camhan22/Go-Kart/Pictures/Day I got it/20170626_204428(0).jpg

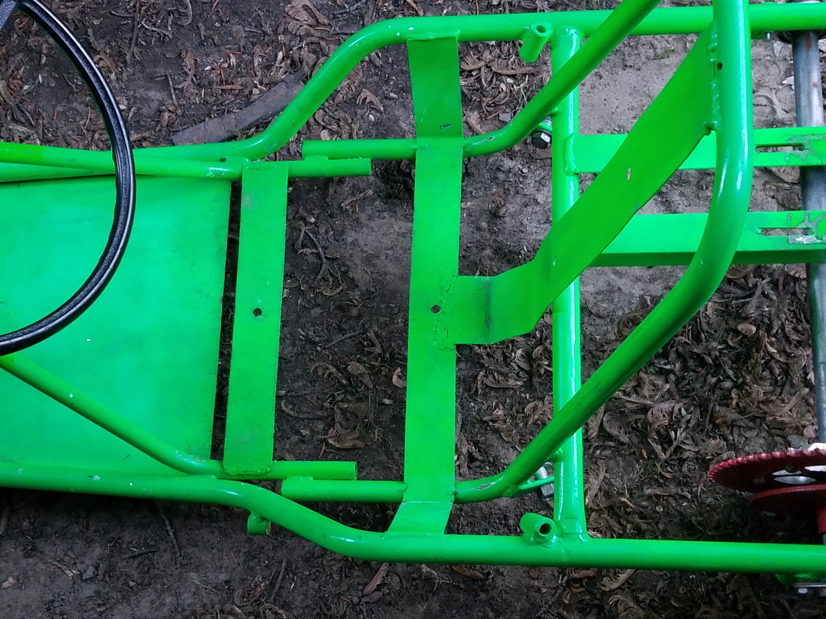
Pictures/Day I got it/20170626_204428(0).jpg
