camhan22/Go-Kart/README.md

# Go-Kart
Electric Go-Kart using 12V FIRST robotics CIM Motors
