camhan22/Go-Kart/Modeling/Notes.txt

Average full throttle acceleration is 6.1535g. (May need to limit the acceleration rate for this system)
