camhan22/Go-Kart/Modeling/Motors/Motor Specifications.xlsx

Sheet: Calculations
Input Voltage | Motor Parameters
12 | Kt | R | B | L | Kv | J
 | 0.01841 | 0.09156461028 | 8.905383993e-05 | 5.9e-05 | 0.0210564841 | 7.75e-05

Sheet: Motor Curve Data
Speed (RPM) | Speed (rad/s) | Torque (N·m) | Friction Torque (N*m) | Eb (V) | Current (A) | Supplied Power (W) | Output Power (W) | Efficiency (%) | Power Dissipation (W)
0 | 0 | 2.413 | 0 | 0 | 131.055 | 1572.66 | 0 | 0 | 1572.66
53.3 | 5.581562948 | 2.38887 | 0.0004888417077 | 0.1175689596 | 129.771 | 1557.252 | 13.334 | 0.856 | 1543.918
106.6 | 11.1631259 | 2.36474 | 0.0009960955324 | 0.2350463546 | 128.488 | 1541.856 | 26.398 | 1.712 | 1515.458
159.9 | 16.74468884 | 2.34061 | 0.00148493724 | 0.3526153142 | 127.204 | 1526.448 | 39.193 | 2.568 | 1487.255
213.2 | 22.32625179 | 2.31648 | 0.001992191065 | 0.4700927092 | 125.921 | 1511.052 | 51.718 | 3.423 | 1459.334
266.5 | 27.90781474 | 2.29235 | 0.002481032772 | 0.5876616688 | 124.637 | 1495.644 | 63.974 | 4.277 | 1431.67
319.8 | 33.48937769 | 2.26822 | 0.002988286597 | 0.7051390638 | 123.354 | 1480.248 | 75.961 | 5.132 | 1404.287
373.1 | 39.07094064 | 2.24409 | 0.003477128305 | 0.8227080233 | 122.07 | 1464.84 | 87.679 | 5.986 | 1377.161
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
