camhan22/Go-Kart/Datasheets/1 IN SHAFT COLLARS.jpg

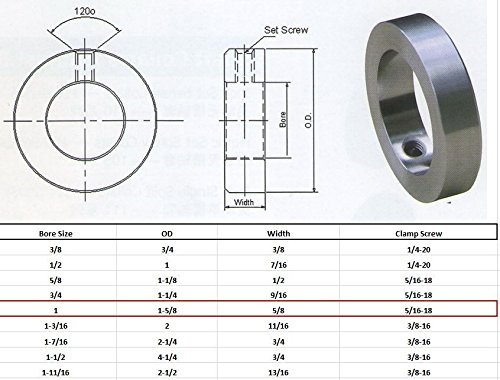
Datasheets/1 IN SHAFT COLLARS.jpg
