camhan22/Go-Kart/Datasheets/51IsZ3rEdWL.jpg

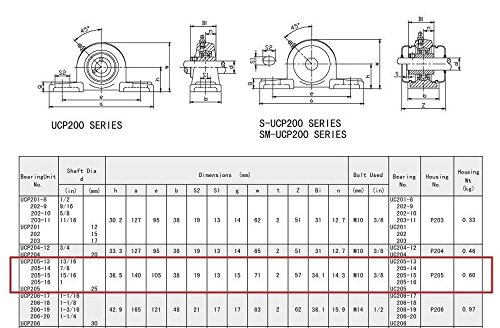
Datasheets/51IsZ3rEdWL.jpg
