camhan22/Go-Kart/Pictures/Foot Pegs - July 17th/20170717_174123.jpg

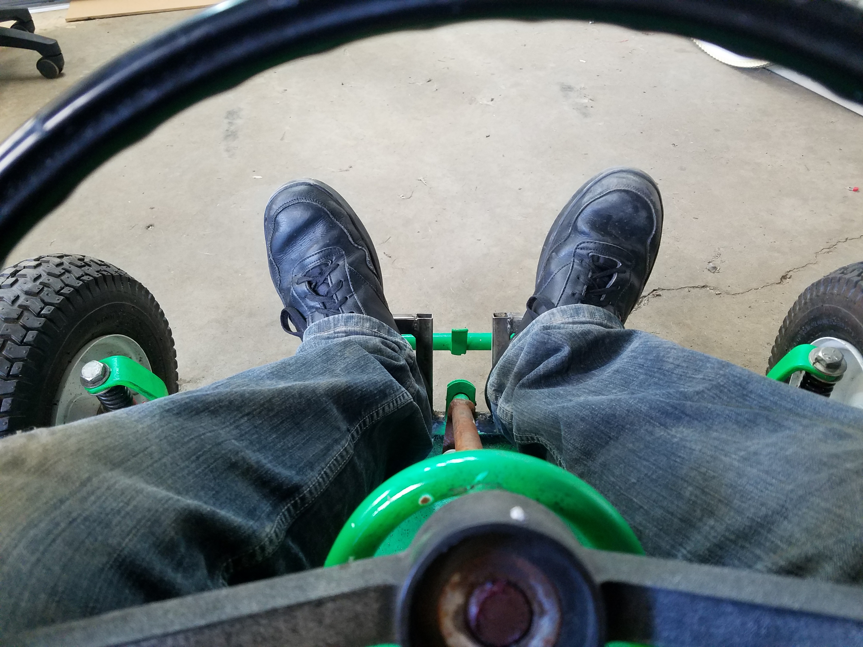
Pictures/Foot Pegs - July 17th/20170717_174123.jpg
