camhan22/Go-Kart/Go-Kart BOM.xlsx

Sheet: BOM
Description | Vendor | Item # | Cost | Quantity Needed | WEIGHT | Notes
SPROCKETS AND CHAIN
1" AXLE 42 TOOTH HUB AND SPROCKET | GOKARTSUSA | 2562 | $47.85 | 2 |  | MAYBE REPLACE WITH 35B42F-1 FROM AMAZON TO REDUCE SHIPPING COST
500EX HEX HUB | ANDYMARK | AM-2568 | $9.50 | 4 | 0.088
#35 CHAIN(10FT) | VEXPRO | 217-2776 | $9.99 | 1 | 1.014
MASTER LINK | ANDYMARK | AM-0368 | $0.75 | 2 | 0.01
42 TOOTH #35 SPROCKET | VEXPRO | 217-2648 | $12.99 | 2 | 0.28
 |  |  | Total: | $171.17
DRIVETRAIN COMPONENTS
2.5" CIM MOTOR | VEXPRO | 217-2000 | $27.99 | 6 | 2.82
3 CIM BALL SHIFTER | VEXPRO | 217-3268 | $241.94 | 2 | 3.903 | 3.68 Spread with 3rd stage at 50:34
12V 30 AMP BATTERY CHARGER | BATTERYSTUFF | SEC-1230UL | $218.00 | 1 | 0
120 AMP MAIN BREAKER | AMAZON.COM | CB185-120 | $29.98 | 1 | 0.2
12V DURACELL ULTRA BATTERY | BATTERIES PLUS | SLI12V215S | $332.99 | 1 | 127
6 WAY FUSE HOLDER | AMAZON.COM | NC-A001-20 | 12.99 | 1 | 0.2625
4 AWG BLACK WIRE(BY THE FOOT) | HOME DEPOT | 20502199 | 0.86 | 3
4 AWG RED WIRE(BY THE FOOT) | HOME DEPOT | 20498299 | 1.19 | 3
COMPLETE SPINDLE SET (4-1/2" X 5/8") | BMI KARTS | 421400 | $31.50 | 2 |  | FOR THE FRONT END
3/4 x 16 NYLOCK HEX NUTS | EBAY.COM | 3/4 x 16 NYLOCK HEX NUTS | $13.10 | 1 |  | 25 per bag
7" X 5-3/4" FRONT RIMS | BMI KARTS | K260037 | $18.95 | 2
PAIR REAR AXLE PILLOW BLOCK | AMAZON.COM | UCP205-16 | $16.68 | 2 | 6
7" X 5-3/4" RIM (1" BORE) | BMI KARTS | 260038 | $18.95 | 2 |  | FOR THE REAR TIRES
KENDA K530 PATHFINDER TIRES | EBAY.COM | 1877KPF-2 | $70.80 | 1 |  | COMES AS A PAIR WITH FREE SHIPPING
1" DIA. 48" LONG KEYED SHAFT | AMAZON.COM | 1 GKS-1045-48 | $60.99 | 1
1" BORE ZINC PLATED SHAFT COLLARS | AMAZON.COM | 762931496962 | $15.50 | 2 |  | FREE SHIPPING
18-8 1/4" KEYWAY(12" LONG) | AMAZON.COM | SPKS279 | $8.71 | 2 | 0.2175
 |  |  | Total: | $1507.99
DISPLAY COMPONENTS
PANEL MOUNT VOLTMETER WITH CURRENT SHUNT | AMAZON.COM | 711463670166 | $18.75 | 1
I2C 2004 LCD SCREEN | AMAZON.COM | B01GPUMP9C | $11.99 | 1
4 PIN LATCHING ROCKER SWITCH | AMAZON.COM | USS-WBS00009 | $6.95 | 1
 |  |  | Total: | $37.69
Frame
KART FRAME
 |  |  |  | 1 | 81.83
 |  |  | Total: | $0.00
Controls
SLIDE POTENTIOMETER(10k)(100mm) | MOUSER | 652-PTB01532010BPB10 | $4.93 | 1
ARDUINO MEGA2560 | AMAZON.COM | B01H4ZLZLQ | $12.86 | 1
ADAFRUIT ULTIMATE GPS | AMAZON.COM | OMEL-MR-PN-6693723 | $39.93 | 1
10" STEERING WHEEL | AMAZON.COM | B005FMT2RA | $23.88 | 1
JEGS PERFORMANCE SEAT | AMAZON.COM | 555-70200 | $34.99 | 1
4 POINT RACE HARNESS | AMAZON.COM | 2V-8TCC-ASKP | $29.99 | 1
12V 2 POSITION SOLENOID | EBAY.COM | 4V210-08 DC12V | $9.69 | 1
300 PSI MINI AIR COMPRESSOR | EBAY.COM | 672588 | $10.26 | 1
BALL SHIFTER PNUEMATIC FITTING KIT | VEXPRO | 217-2907 | $9.99 | 1
1/4" O.D. 25FT ROLL TUBING | HOME DEPOT | 701873 | $3.98 | 1
PNUEMATIC PRESSURE REGULATOR | AMAZON.COM | BTFP72326 | $10.44 | 1
1/4" MALE THREAD TO PUSH CONNECT FITTINGS | AMAZON.COM | J06 | $7.99 | 1
 |  |  | Total: | $198.93
TOTAL COST: | $1915.78 |  |  | WEIGHT: | 248.3995

Sheet: ORDERING
VEXPRO | QTY | ANDYMARK | QTY | GOKARTSUSA | QTY | EBAY.COM | QTY | AMAZON.COM | QTY | METALSDEPOT | QTY | MOUSER | QTY | BMI KARTS | QTY | HOME DEPOT | QTY | BATTERYSTUFF | QTY
217-2776 | 1 | AM-2568 | 4 | 2562 | 2 | 3/4 x 16 NYLOCK HEX NUTS | 1 | CB185-120 | 1 |  |  | 652-PTB01532010BPB10 | 1 | 421400 | 2 | 20502199 | 3 | SEC-1230UL | 1
217-2648 | 2 | AM-0368 | 2 |  |  | 1877KPF-2 | 1 | NC-A001-20 | 1 |  |  |  |  |  |  | 20498299 | 3
217-2000 | 6 |  |  |  |  | 4V210-08 DC12V | 1 | UCP205-16 | 2 |  |  |  |  |  |  | 701873 | 1
217-3268 | 2 |  |  |  |  | 672588 | 1 | 1 GKS-1045-48 | 1
217-2907 | 1 |  |  |  |  |  |  | 762931496962 | 2
 |  |  |  |  |  |  |  | SPKS279 | 2
 |  |  |  |  |  |  |  | 711463670166 | 1
 |  |  |  |  |  |  |  | B01GPUMP9C | 1
 |  |  |  |  |  |  |  | USS-WBS00009 | 1
 |  |  |  |  |  |  |  | B01H4ZLZLQ | 1
 |  |  |  |  |  |  |  | OMEL-MR-PN-6693723 | 1
 |  |  |  |  |  |  |  | B005FMT2RA | 1
 |  |  |  |  |  |  |  | 555-70200 | 1
 |  |  |  |  |  |  |  | 2V-8TCC-ASKP | 1
 |  |  |  |  |  |  |  | BTFP72326 | 1
 |  |  |  |  |  |  |  | J06 | 1

Sheet: PREMADE FRAME
Description | Vendor | Item # | Cost | Quantity Needed | WEIGHT | Notes
SPROCKETS AND CHAIN
1" AXLE 42 TOOTH HUB AND SPROCKET | GOKARTSUSA | 2562 | $21.90 | 2
500EX HEX HUB | ANDYMARK | AM-2568 | $9.50 | 4
#35 CHAIN(10FT) | ANDYMARK | AM-0367 | $12.00 | 1
MASTER LINK | ANDYMARK | AM-0368 | $0.75 | 2
42 TOOTH #35 SPROCKET | VEXPRO | 217-2648 | $12.99 | 2
 |  |  | Total: | $121.28
DRIVETRAIN COMPONENTS
2.5" CIM MOTOR | VEXPRO | 217-2000 | $27.99 | 6
3 CIM BALL SHIFTER | VEXPRO | 217-3268 | $241.94 | 2 |  | 3.68 Spread with 3rd stage at 50:34
12V DURALAST PLATINUM BATTERY | AUTOZONE | H8-AGM | $207.99 | 2
REAR AXLE PILLOW BLOCK | AMAZON.COM | UCP205-16 | $14.98 | 4
 |  |  | Total: | $1127.72
DISPLAY COMPONENTS
PANEL MOUNT VOLT METER | EBAY.COM | PANEL MOUNT VOLT METER | $13.95 | 1
4 PIN LATCHING ROCKER SWITCH | AMAZON.COM | USS-WBS00009 | $6.95 | 1
 |  |  | Total: | $20.90
Frame
 |  |  | Total: | $0.00
Controls
SLIDE POTENTIOMETER(10k)(100mm) | MOUSER | 652-PTB01532010BPB10 | $4.93 | 1
ARDUINO MEGA2560 | AMAZON.COM | B01H4ZLZLQ | $12.86 | 1
12V 2 POSITION SOLENOID | EBAY.COM | 4V210-08 DC12V | $9.69 | 1
300 PSI MINI AIR COMPRESSOR | EBAY.COM | 672588 | $10.26 | 1
BALL SHIFTER PNUEMATIC FITTING KIT | VEXPRO | 217-2907 | $9.99 | 1
1/4" O.D. 25FT ROLL TUBING | HOME DEPOT | 701873 | $3.98 | 1
PNUEMATIC PRESSURE REGULATOR | AMAZON.COM | BTFP72326 | $10.44 | 1
1/4" MALE THREAD TO PUSH CONNECT FITTINGS | AMAZON.COM | J06 | $7.99 | 1
 |  |  | Total: | $70.14
TOTAL COST: | $1340.04

Sheet: PREMADE FRAME ORDERING
VEXPRO | QTY | ANDYMARK | QTY | GOKARTSUSA | QTY | AUTOZONE | QTY | EBAY.COM | QTY | AMAZON.COM | QTY | METALSDEPOT | QTY | MOUSER | QTY | BMI KARTS | QTY | HOME DEPOT | QTY
217-2648 | 2 | AM-2568 | 4 | 2562 | 2 | H8-AGM | 2 | PANEL MOUNT VOLT METER | 1 | UCP205-16 | 4 |  |  | 652-PTB01532010BPB10 | 1 |  |  | 701873 | 1
217-2000 | 6 | AM-0367 | 1 |  |  |  |  | 4V210-08 DC12V | 1 | USS-WBS00009 | 1
217-3268 | 2 | AM-0368 | 2 |  |  |  |  | 672588 | 1 | B01H4ZLZLQ | 1
217-2907 | 1 |  |  |  |  |  |  |  |  | BTFP72326 | 1
 |  |  |  |  |  |  |  |  |  | J06 | 1
