camhan22/Go-Kart/Modeling/Go-Kart BOM.xlsx

Item | Description | Part Number | Cost | Quantity | Actual Qty | Manufacturer | Supplier | Purchased | Webstore Link
Drivetrain
Motor | 2.5" CIM Motor with no output gear |  | $33.00 | 6 | 6 | AndyMark | AndyMark | N | https://www.andymark.com/products/2-5-in-cim-motor?Pinion%20Option=No%20Pinion&quantity=1
Cim Motor Gear | 14 Tooth 20DP 8 mm Round with 2 mm Key Steel CIM Gear |  | $10.00 | 6 | 6 | AndyMark | AndyMark | N | https://www.andymark.com/products/14t-20dp-8mm-round-with-2mm-key-steel-gear
Optical Encoder for Speed | E4T OEM Miniature Optical Encoder Kit |  | $38.00 | 2 | 2 | AndyMark | AndyMark | N | https://www.andymark.com/products/e4t-oem-miniature-optical-encoder-kit
Encoder Mount | Encoder Mount Pad Spacer V2 |  | $3.50 | 2 | 2 | AndyMark | AndyMark | N | https://www.andymark.com/products/encoder-mount-pad-v2
Transmission | Toughbox Gearbox 3 Motor with 12.75:1 Ratio |  | $79.00 | 2 | 2 | AndyMark | AndyMark | N | https://www.andymark.com/products/toughbox-3-motor-with-12-75-1-ratio
Chain | #35 Single Strand-Riveted Roller Chain 10' |  | $12.00 | 1 | 1 | AndyMark | AndyMark | N | https://www.andymark.com/products/35-single-strand-riveted-roller-chain-10
Chain Master Links | #35 Roller Chain Connecting Link |  | $1.00 | 0 | 5 | AndyMark | AndyMark | N | https://www.andymark.com/products/35-connecting-link-for-roller-chain
Chain Half Links | #35 Roller Chain Half Link |  | $2.00 | 0 | 5 | AndyMark | AndyMark | N | https://www.andymark.com/products/35-half-link-for-roller-chain
Tranmission Output Gear |  |  |  | 1 | 1 | AndyMark | AndyMark
Drive Shaft Gear |  |  |  | 1 | 1 | AndyMark | AndyMark
Throttle
Potentiometer to Digital Converter | Dual channel 256 step digital potentiometer IC | ‎DS18030-010+-ND | $4.83 | 1 | 2 | Maxim Integrated | Digi-Key | Y | https://www.digikey.com/en/products/detail/maxim-integrated/DS18030-010/951284
Throttle Potentiometers | 10k 250 degree pots | 284TBCF103A26A1 | $12.38 | 2 | 2 | CTS Electrocomponents | Digi-Key | Y | https://www.digikey.com/en/products/detail/cts-electrocomponents/284TBCF103A26A1/3045559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
