camhan22/Go-Kart/E2M Converter/BOM.xlsx

Schematic Annotation | Part Number | Description | Qty | Price | Supplier | Total Cost | Link
U2 | ATTINY85-20PU-ND | AVR series Microcontroller IC 8-Bit 20MHz 8KB (4K x 16) FLASH 8-PDIP | 1 | $1.45 | Digikey | $1.45 | https://www.digikey.com/en/products/detail/microchip-technology/ATTINY85-20PU/735469
U1 | 497-2947-5-ND | Linear Voltage Regulator IC Positive Fixed 1 Output 1.5A TO-220AB | 1 | $0.54 | Digikey | $0.54 | https://www.digikey.com/en/products/detail/stmicroelectronics/L7805ABV/634711
J1 | 277-6156-ND | 2 Position Wire to Board Terminal Block 45° (135°) Angle with Board 0.098" (2.50mm) Through Hole | 1 | $0.31 | Digikey | $0.31 | https://www.digikey.com/en/products/detail/phoenix-contact/1989748/2513965
J2 | 23-0022292051-ND | Connector Header Through Hole 5 position 0.100" (2.54mm) | 1 | $1.43 | Digikey | $1.43 | https://www.digikey.com/en/products/detail/molex/0022292051/1130591
J2 Mate | 23-0010112053-ND | 5 Rectangular Connectors - Housings Receptacle White 0.100" (2.54mm) | 1 | $0.29 | Digikey | $0.29 | https://www.digikey.com/en/products/detail/molex/0010112053/171981
J2 Crimps | WM3724CT-ND | Socket Contact Tin 22-28 AWG Crimp - | 5 | $0.12 | Digikey | $0.60 | https://www.digikey.com/en/products/detail/molex/0008700056/2421861
C1,C2 | 732-8851-1-ND | 1 µF 50 V Aluminum Electrolytic Capacitors Radial, Can - 2000 Hrs @ 105°C | 2 | $0.10 | Digikey | $0.20 | https://www.digikey.com/en/products/detail/w%C3%BCrth-elektronik/860020672005/5728796
M2 | 102-5593-ND | Fan Tubeaxial 12VDC Square - 40mm L x 40mm H omniCOOL™ Magnetic Sleeve 5.5 CFM (0.154m³/min) 2 Wire Leads | 1 | $5.57 | Digikey | $5.57 | https://www.digikey.com/en/products/detail/cui-devices/CFM-4020V-145-123/7605411
Heatsink | HS106-ND | Heat Sink TO-220 Aluminum 3.0W @ 80°C Board Level | 1 | $0.33 | Digikey | $0.33 | https://www.digikey.com/en/products/detail/aavid-thermal-division-of-boyd-corporation/577102B00000G/108319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
Heatsink Bolt | 91274A102 | Zinc-Aluminum-Coated Alloy Steel Socket Head Screw | 1 | $5.38 | Mcmaster Carr | $5.38 | https://www.mcmaster.com/91274A102/
Heatsink Nut | 90592A085 | Steel Hex Nut | 1 | $1.17 | Mcmaster Carr | $1.17 | https://www.mcmaster.com/90592A085/
Servo Motor | 1528-1083-ND | Positional Rotation DC Motor Servomotor, RC (Hobby) - - - 5VDC | 1 | $19.95 | Digikey | $19.95 | https://www.digikey.com/en/products/detail/adafruit-industries-llc/1142/5154658
Throttle Cable | B071VPYPD7 | 82 Inch Go Kart Throttle Cable Line Wire For 150CC 250CC Carter Throttle Cable Accessories | 1 | $9.50 | Amazon.com | $9.50 | Amazon.com: 82 Inch Go Kart Throttle Cable Line Wire For 150CC 250CC Carter Throttle Cable Accessories: Automotive (https://www.amazon.com/Throttle-Cable-150CC-Carter-Accessories/dp/B071VPYPD7)
 |  |  |  |  | Total Cost | $46.72
