camhan22/Go-Kart/Throttle/BOM.xlsx

Schematic Annotation | Part Number | Description | Qty | Price | Supplier | Total Cost | Link
 | 1772-1230-ND | Hex Standoff Threaded #4-40 Aluminum 0.250" (6.35mm) 1/4" - | 4 | $0.46 | Digikey | $1.84 | https://www.digikey.com/en/products/detail/raf-electronic-hardware/4501-440-AL/7680641
 | H216-ND | #4-40 Hex Nut 0.250" (6.35mm) 1/4" - | 4 | $0.02 | Digikey | $0.08 | https://www.digikey.com/en/products/detail/b-f-fastener-supply/HNZ-440/5738
 | 1528-1195-ND | Breadboard, General Purpose Plated Through Hole (PTH) 5 Hole Pad (Both Sides) - | 1 | $4.50 | Digikey | $4.50 | https://www.digikey.com/en/products/detail/adafruit-industries-llc/1609/5353655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
 | 2139580 | M6-1.0 x 100mm DIN 912 Hex Drive Class 12.9 Black Oxide Finish Alloy Steel Socket Cap Screw | 2 | $1.75 | Fastenal | $3.50 | https://www.fastenal.com/products/details/2139580
 | 210129065 | M6-1.0 DIN 934 Yellow Zinc Finish Steel Class 10 Hex Nut | 2 | $0.35 | Fastenal | $0.70 | https://www.fastenal.com/products/details/210129065
 | 11545703 | M6 x 12mm OD DIN 125 Grade HV200 Yellow Zinc Finish Steel Type A General Purpose Flat Washer | 2 | $0.17 | Fastenal | $0.35 | https://www.fastenal.com/products/details/11545703
U1 | ATTINY85-20PU-ND | AVR series Microcontroller IC 8-Bit 20MHz 8KB (4K x 16) FLASH 8-PDIP | 1 | $1.45 | Digikey | $1.45 | https://www.digikey.com/en/products/detail/microchip-technology/ATTINY85-20PU/735469
J1 | 23-0022292051-ND | Connector Header Through Hole 5 position 0.100" (2.54mm) | 1 | $1.43 | Digikey | $1.43 | https://www.digikey.com/en/products/detail/molex/0022292051/1130591
J1 Mate | 23-0010112053-ND | 5 Rectangular Connectors - Housings Receptacle White 0.100" (2.54mm) | 1 | $0.29 | Digikey | $0.29 | https://www.digikey.com/en/products/detail/molex/0010112053/171981
J1 Crimps | WM3724CT-ND | Socket Contact Tin 22-28 AWG Crimp - | 4 | $0.12 | Digikey | $0.48 | https://www.digikey.com/en/products/detail/molex/0008700056/2421861
J2 | 277-6156-ND | 2 Position Wire to Board Terminal Block 45° (135°) Angle with Board 0.098" (2.50mm) Through Hole | 1 | $0.31 | Digikey | $0.31 | https://www.digikey.com/en/products/detail/phoenix-contact/1989748/2513965
RV1, RV2 | CT3033-ND | 10k Ohm 1 Gang Linear Panel Mount Potentiometer None 1.0 Kierros Conductive Plastic 0.25W, 1/4W Solder Lug | 2 | $11.90 | Digikey | $23.80 | https://www.digikey.com/en/products/detail/cts-electrocomponents/284TBCF103A26A1/3045559
 |  |  |  |  | Total Cost | $38.73
