camhan22/Go-Kart/Throttle/Throttle Body.stl

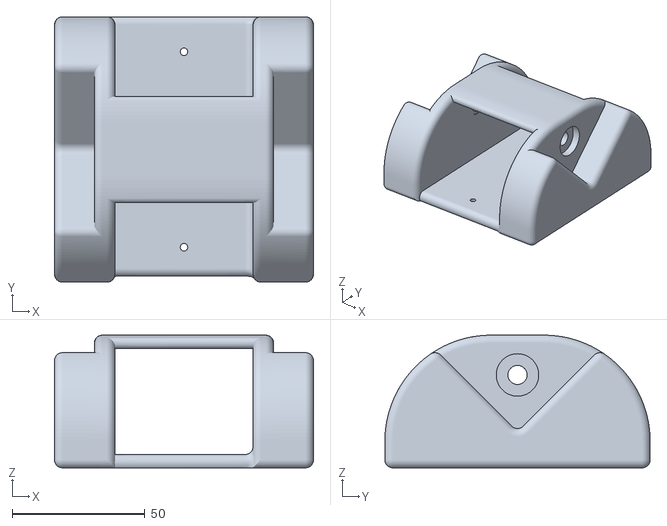
[picture p13: CAD file, 2021-06-26]
Throttle/Throttle Body.stl
97.6 x 100.0 x 50.0
