camhan22/Go-Kart/Throttle/Throttle Handle.stl

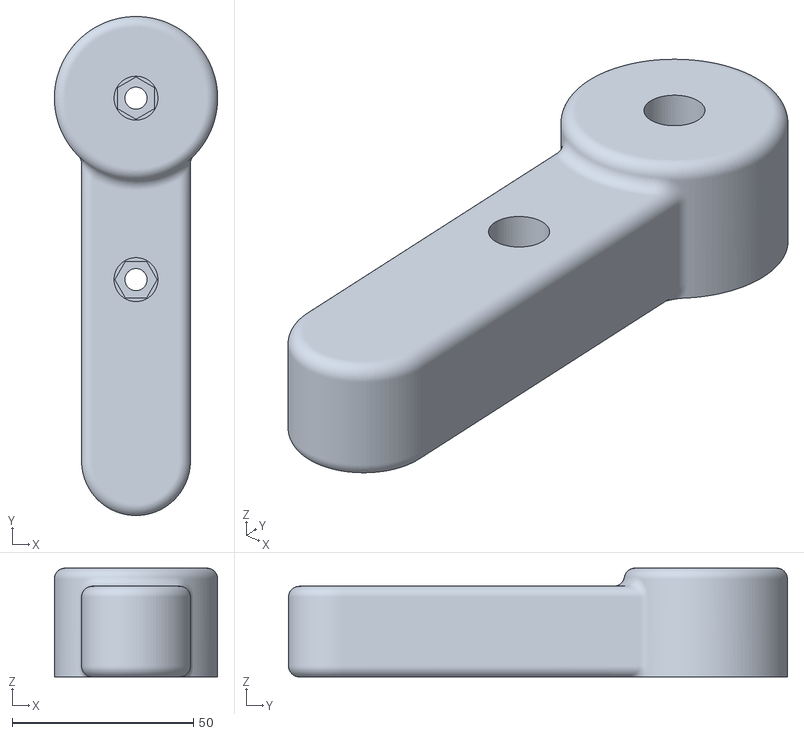
[picture p14: CAD file, 2021-06-23]
Throttle/Throttle Handle.stl
45.0 x 137.5 x 30.0
