camhan22/Go-Kart/Throttle/Handle Connector.stl

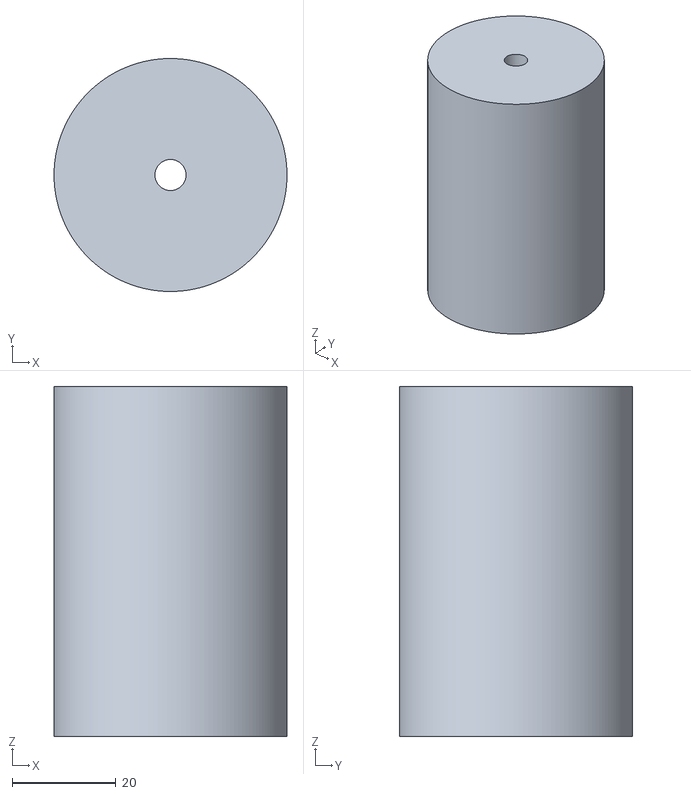
[picture p15: CAD file, 2021-06-23]
Throttle/Handle Connector.stl
45.0 x 45.0 x 67.6
