camhan22/Go-Kart/Throttle/Clamper.stl

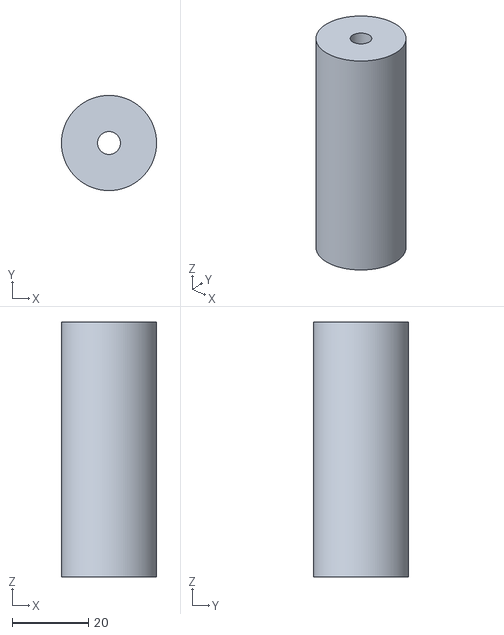
[picture p16: CAD file, 2021-06-20]
Throttle/Clamper.stl
25.0 x 25.0 x 67.0
