camhan22/Go-Kart/E2M Converter/E2M Converter/E2M Converter.kicad_pcb

## KiCad design E2M Converter/E2M Converter/E2M Converter.kicad_pcb (2021-06-29)

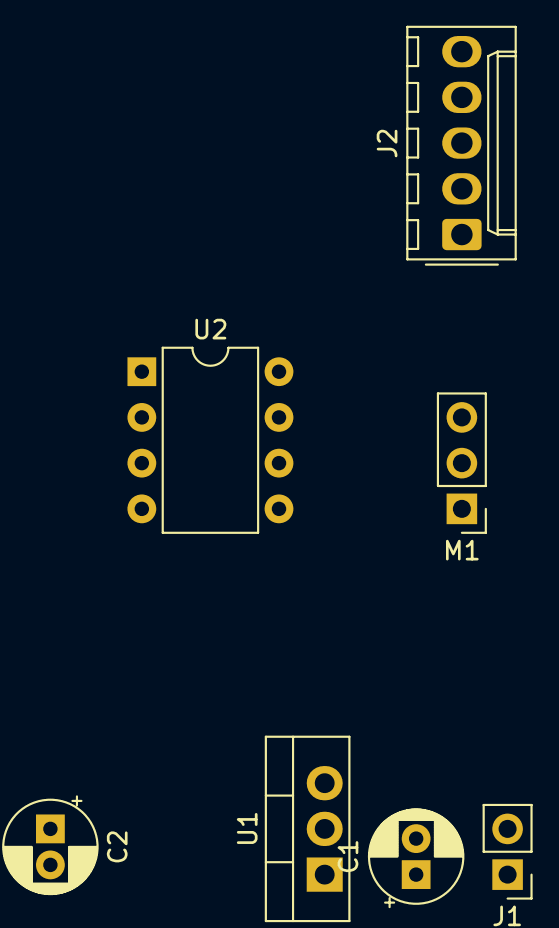
[picture p17: board E2M Converter.kicad_pcb from above]

Board: 2 copper layers, 7 parts (0 on the bottom side), 7 nets, no tracks yet.

Parts:
C1, C2: 1uF; CP_Radial_D5.0mm_P2.00mm
J1: Input Connector; PinHeader_1x02_P2.54mm_Vertical
J2: Conn_01x05; Molex_KK-254_AE-6410-05A_1x05_P2.54mm_Vertical
M1: Motor_Servo; PinHeader_1x03_P2.54mm_Vertical
U1: L7805 TO220; TO-220-3_Vertical
U2: ATtiny85-20PU; DIP-8_W7.62mm

Connections:
+5V: C2.1, M1.2, U1.3, U2.8
+12V: C1.1, J1.1, U1.1
GND: C1.2, C2.2, J1.2, J2.5, M1.3, U1.2, U2.4
MISO: J2.2, M1.1, U2.6
RESET: J2.4, U2.1
SCL-SCK: J2.1, U2.7
SDA-MOSI: J2.3, U2.5
