camhan22/Go-Kart/Throttle/Go-Kart Throttle/Go-Kart Throttle.sch

## KiCad design Throttle/Go-Kart Throttle/Go-Kart Throttle.sch (2021-08-14)

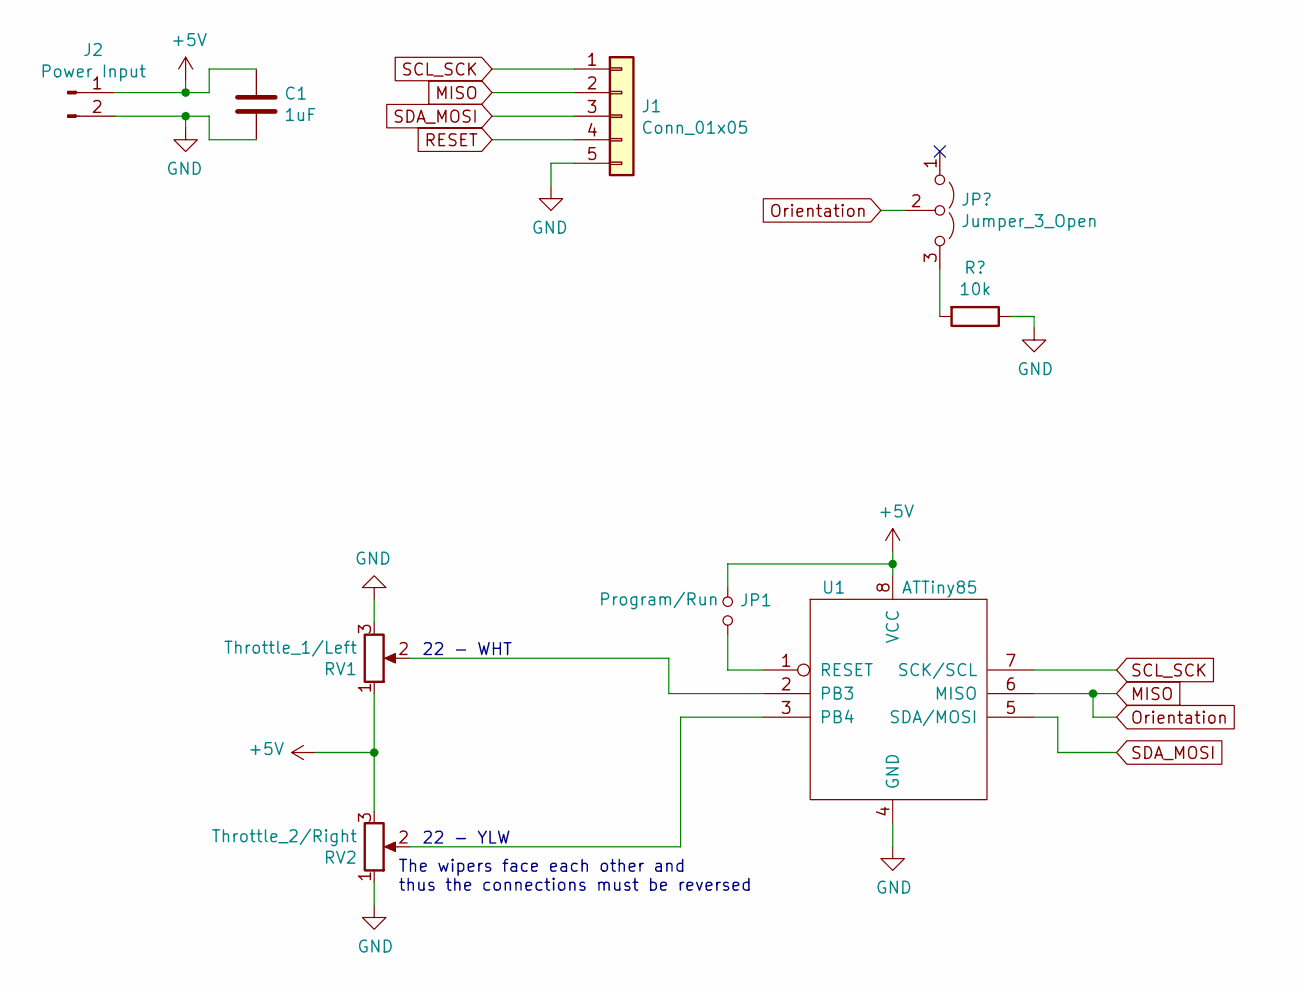
[picture p18: schematic Go-Kart Throttle.sch]

Parts:
C1: 1uF
J1: Conn_01x05
J2: Power Input
JP1: Program/Run
RV1: Throttle_1/Left
RV2: Throttle_2/Right
U1: ATTiny85

Connections:
+5V: C1.1, J2.1, JP1.1, RV1.1, RV2.3, U1.8 (VCC)
GND: C1.2, J1.5, J2.2, RV1.3, RV2.1, U1.4 (GND)
MISO: J1.2, U1.6 (MISO)
unnamed: JP1.2, U1.1 (RESET)
unnamed: RV1.2, U1.2 (PB3)
unnamed: RV2.2, U1.3 (PB4)
RESET: J1.4
SCL_SCK: J1.1, U1.7 (SCK/SCL)
SDA_MOSI: J1.3, U1.5 (SDA/MOSI)

Notes on the sheet:
The wipers face each other and thus the connections must be reversed
22 - WHT
22 - YLW
