camhan22/Go-Kart/(commit log)

2021-06-15 Added Schematic
2021-06-15 Added annotations to schematic
    [BOM.xlsx, Go-Kart Throttle.sch]
2021-06-15 Added Throttle controller code
2021-06-20 Changed stuff
    Added a throttle tester.
    Added the wiring schematic for the whole kart and updated schematics for throttle
    [BOM.xlsx, Cables.sch, Clamper.stl, Go-Kart Main Wiring.kicad_pcb, Go-Kart Main Wiring.sch, Go-Kart Throttle.sch, Handle Connector.stl, Throttle Body.stl]
2021-06-20 Added status codes
    [Throttle Status Codes.xlsx]
2021-06-23 Updated STL parts
    [BOM.xlsx, Handle Connector.stl, Throttle Handle.stl]
2021-06-24 Changed scaling
    Changed how the scaling is input inside the map function. Now, the min and max values are based off measured values. May add code to update these limits as heat will change these values. This was something I noticed when measuring the voltages.
2021-06-24 Added voltage scaling to system
2021-06-25 Made the throttle calibrate itself on startup
2021-06-26 Updated throttle body.stl to include physical stops due to potentiometer not able to read at its mechanical stops
    [Throttle Body.stl]
2021-06-29 E2M Converter created
    Created a system to convert the electrical throttle to an electrical signal to work with briggs and stratton 192402 motor that can be used instead of electric system
    [BOM.xlsx, E2M Converter.kicad_pcb, E2M Converter.sch, E2M Status Codes.xlsx]
2021-07-01 Updated and verified model
    [Cim-Motor Model Parameters.txt, EML Wheel Calculations.xlsx, Go-Kart BOM.xlsx, Motor Specifications.xlsx]
2021-08-14 Updated schematic and code
    Added pulldown resistor instead of direct grounding on MOSI line due to not being able to program it.
    Also added EEPROM code to store the calibration to not have to calibrate each time at startup. Calibration can be forced if the throttle is in the full on position when in the normal orientation
    [Go-Kart Throttle.sch]
